g-ampo/mesh_module/ESP_mesh_module/Mesh_Gerbers/BOM.xlsx

Comment | Designator | Footprint | LCSC Part #
BAT54JFILM | D1 | SOT-323 | C86299 | -
BC817 | Q1, Q2 | SOD-23 | C52801 | -
10k | R1, R2, R3, R4 | 0805_R | C115295 | -
CP2102N-A01 | U2 | QFN-28 | C6568 | -
2k2 | R9, R11 | 0805_R | C26017 | -
22k | R7 | 0805_R | C139902 | -
47k | R8, R10 | 0805_R | C139872 | -
0R | R6, R5, R14, R15, R16, R17, R18, R22, R23, R24, R25, R26 | 0805_R | C702869 | -
PESD5V0L 1BA | D8, D9, D10 | SOD-323 | C85380 | -
100nF | C2, C3, C4, C5, C7, C11 | 0805_C | C360619 | -
4.7uF, 25V | C6 | 0805_C | C1779 | -
22uF, 25V | C1 | 0805_C | C5674 | -
ESP32-WROOM-32 | U1 | WiFi Module | C6568 | -
220 | R19, R20, R21 | 0805_R | C165202 | -
BZX84C47LT3 | D3, D4 | SOT-23 | C118591 | -
IRF7343PBF | Q3 | SOIC-8 | C558150
NCP1117-3.3 | U3 | SOT-223 | C146799 | -
10uF, 16V | C8, C9, C10 | 0805_C | C17024 | -
KPTD-3216SRC-PRV | D2, D5, D6, D7 | 1206_LED | C598387 | -
