g-ampo/mesh_module/ESP_mesh_module/Mesh Module Schematics.pdf

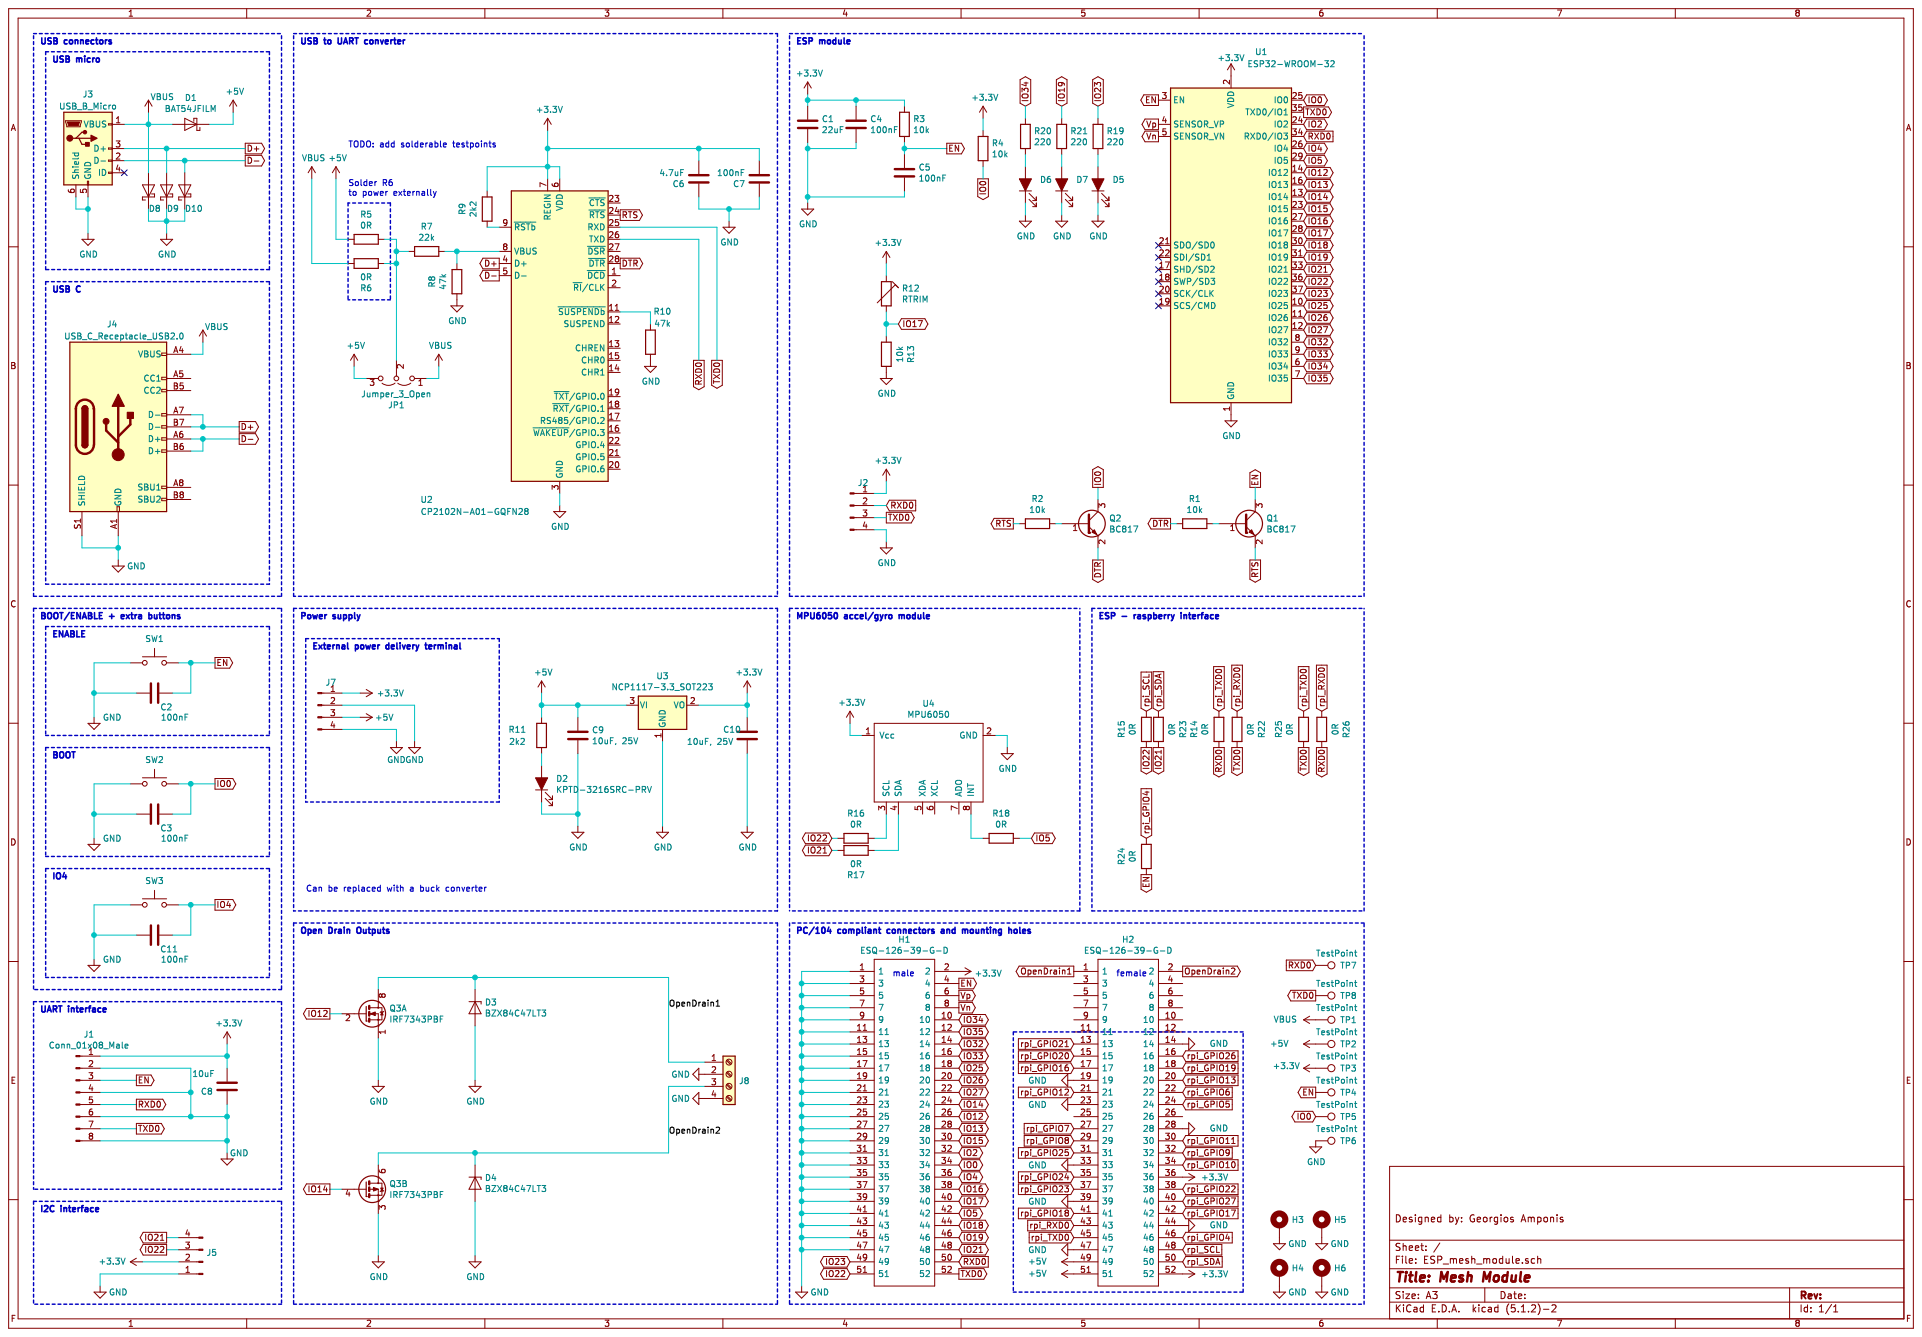
[picture p1: page 1]
