g-ampo/mesh_module/ESP_mesh_module/ESP_mesh_module.kicad_pcb

## KiCad design ESP_mesh_module/ESP_mesh_module.kicad_pcb (2020-11-23)

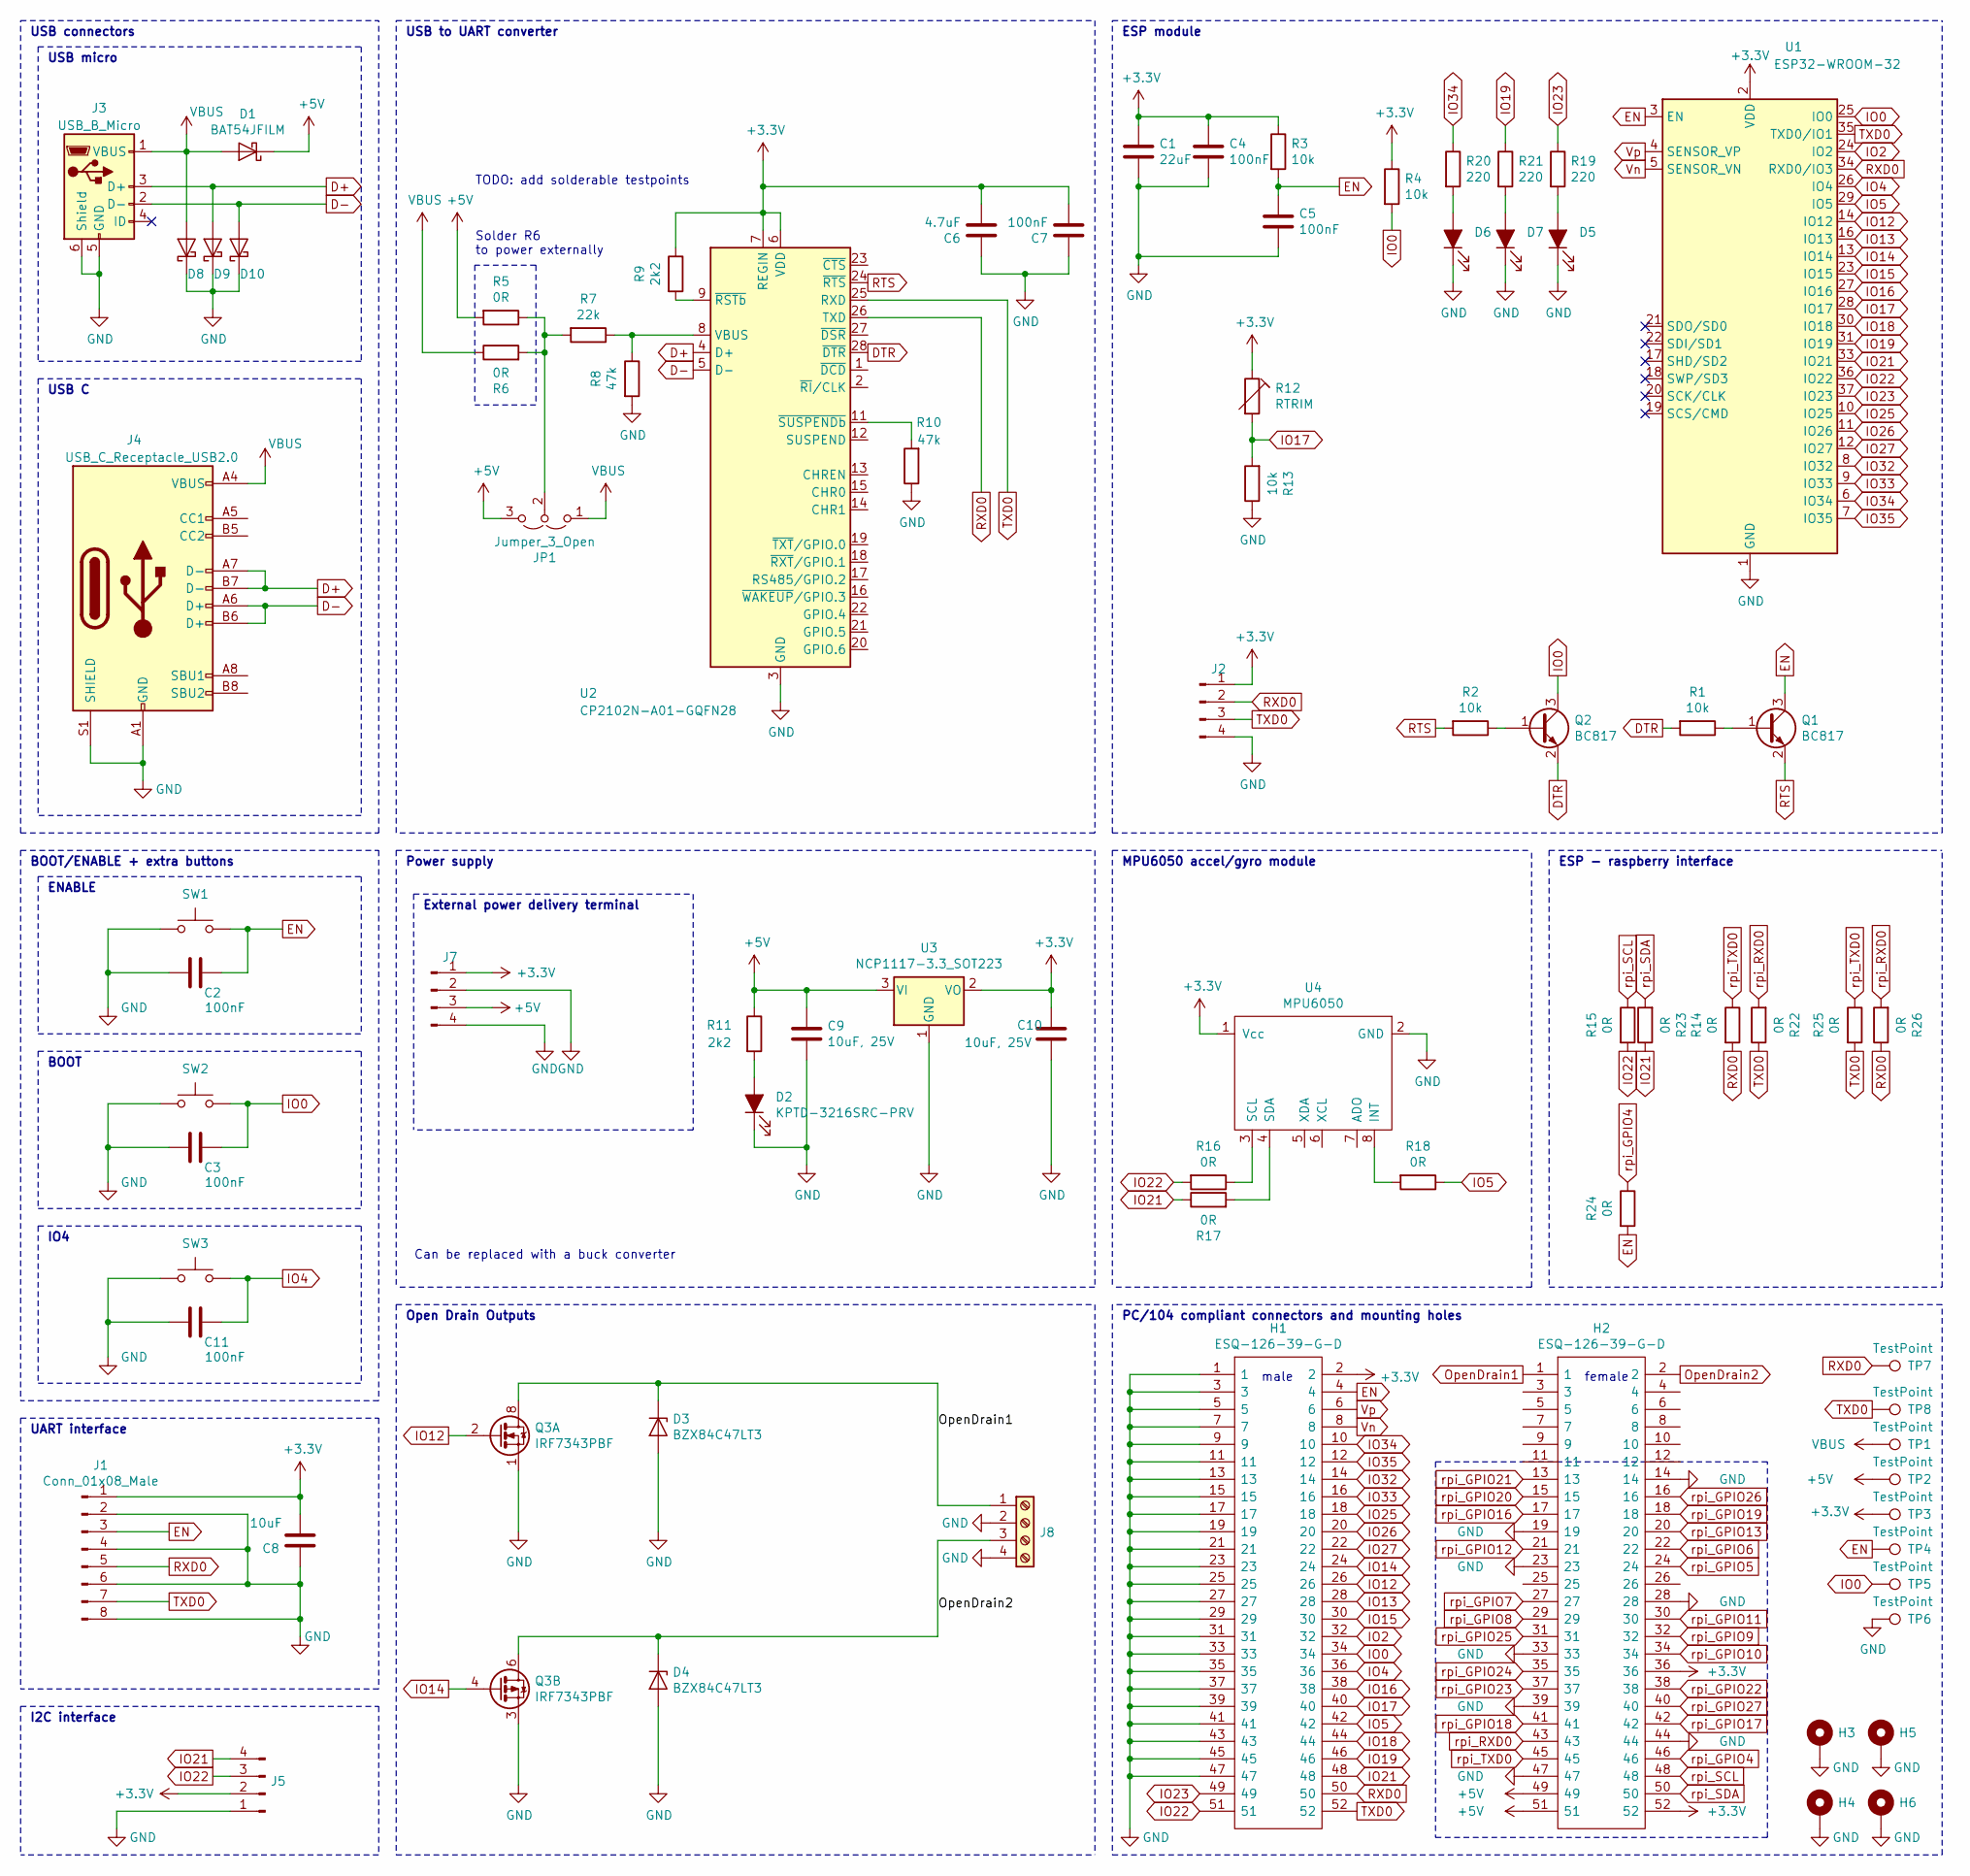
[picture p2: schematic ESP_mesh_module.sch, Mesh Module]

Parts:
C1: 22uF; R_0805_2012Metric; LCSC C5674
C2, C3, C4, C5, C7, C11: 100nF; R_0805_2012Metric; LCSC C360619
C6: 4.7uF; R_0805_2012Metric; LCSC C1779
C8: 10uF; R_0805_2012Metric; LCSC C17024
C9, C10: 10uF, 25V; R_0805_2012Metric; LCSC C17024
D1: BAT54JFILM; D_SOD-323_HandSoldering
D2, D5, D6, D7: KPTD-3216SRC-PRV; LED_1206_3216Metric; LCSC C598387
D3, D4: BZX84C47LT3; D_SOT-23_ANK; LCSC C118591
D8, D9, D10: PESD5V0L 1BA; D_SOD-323_HandSoldering; LCSC C85380
H1, H2: ESQ-126-39-G-D; SHDR52W64P254_2X26_6550X495X1384P; Manufacturer_Part_Number ESQ-126-39-G-D; Mouser Part Number 200-ESQ12639GD
H3, H4, H5, H6: MountingHole_Pad; Mounting_hole_PC104
J1: Conn_01x08_Male; IDC-Header_2x04_P2.54mm_Vertical
J2, J5, J7: Conn_01x04_Male; PinHeader_1x04_P2.54mm_Vertical
J3: USB_B_Micro; USB_Micro-B_Molex_47346-0001
J4: USB_C_Receptacle_USB2.0
J8: Screw_Terminal_01x04; PinHeader_1x04_P2.54mm_Vertical
JP1: Jumper_3_Open; PinHeader_1x03_P2.54mm_Vertical
Q1, Q2: BC817; SOT-23; LCSC C52801
Q3: IRF7343PBF; SOIC-8_3.9x4.9mm_P1.27mm; LCSC C558150
R1, R2, R4: 10k; R_0805_2012Metric; LCSC C115295
R3: 10k; R_0805_2012Metric
R5, R6, R14, R15, R16, R17, R18, R22, R23, R24, R25, R26: 0R; R_0805_2012Metric; LCSC C702869
R7: 22k; R_0805_2012Metric; LCSC C139902
R8, R10: 47k; R_0805_2012Metric; LCSC C139872
R9, R11: 2k2; R_0805_2012Metric; LCSC C26017
R12: RTRIM; Potentiometer_Piher_PT-6-V_Vertical
R13: 10k; R_Axial_DIN0207_L6.3mm_D2.5mm_P7.62mm_Horizontal
R19, R20, R21: 220; R_0805_2012Metric; LCSC C165202
SW1, SW2, SW3: SW_Push; SW_PUSH_6mm
TP1, TP2, TP3, TP4, TP5, TP6, TP7, TP8: TestPoint; TestPoint_Pad_D1.5mm
U1: ESP32-WROOM-32; LCSC C82899
U2: CP2102N-A01-GQFN28; QFN-28-1EP_5x5mm_P0.5mm_EP3.35x3.35mm; LCSC C6568
U3: NCP1117-3.3_SOT223; SOT-223-3_TabPin2; LCSC C146799
U4: MPU6050

Connections:
+3V3: C1.1, C4.1, C6.2, C7.2, C8.2, C10.1, H1.2, H2.36, H2.52, J1.1, J2.1, J5.2, J7.1, R3.1, R4.1, R9.1, R12.1, TP3.1, U1.2 (VDD), U2.6 (VDD), U2.7 (REGIN), U3.2 (VO), U4.1 (Vcc)
+5V: C9.1, D1.1 (K), H2.49, H2.51, J7.3, JP1.3 (B), R5.2, R11.1, TP2.1, U3.3 (VI)
D+: D9.2 (A), J3.3 (D+), J4.A7 (D-), J4.B7 (D-), U2.4 (D+)
D-: D10.2 (A), J3.2 (D-), J4.A6 (D+), J4.B6 (D+), U2.5 (D-)
DTR: Q2.2 (E), R1.2, U2.28 (~DTR)
EN: C2.1, C5.1, H1.4, J1.3, Q1.3 (C), R3.2, R24.2, SW1.2, TP4.1, U1.3 (EN)
GND: C1.2, C2.2, C3.2, C4.2, C5.2, C6.1, C7.1, C8.1, C9.2, C10.2, C11.2, D2.1 (K), D3.2 (A), D4.2 (A), D5.1 (K), D6.1 (K), D7.1 (K), D8.1 (K), D9.1 (K), D10.1 (K), H1.1, H1.3, H1.5, H1.7, H1.9, H1.11, H1.13, H1.15, H1.17, H1.19, H1.21, H1.23, H1.25, H1.27, H1.29, H1.31, H1.33, H1.35, H1.37, H1.39, H1.41, H1.43, H1.45, H1.47, H2.14, H2.19, H2.23, H2.28, H2.33, H2.39, H2.44, H2.47, H3.1, H4.1, H5.1, H6.1, J1.2, J1.4, J1.6, J1.8, J2.4, J3.5 (GND), J3.6 (Shield), J4.A1 (GND), J4.A12 (GND), J4.B1 (GND), J4.B12 (GND), J4.S1 (SHIELD), J5.1, J7.2, J7.4, J8.2, J8.4, Q3.1 (S), Q3.3 (1), R8.2, R10.1, R13.1, SW1.1, SW2.1, SW3.1, TP6.1, U1.1 (GND), U1.15 (GND), U1.38 (GND), U1.39, U2.3 (GND), U2.29 (GND), U3.1 (GND), U4.2 (GND)
IO0: C3.1, H1.34, Q2.3 (C), R4.2, SW2.2, TP5.1, U1.25 (IO0)
IO2: H1.32, U1.24 (IO2)
IO4: C11.1, H1.36, SW3.2, U1.26 (IO4)
IO5: H1.42, R18.1, U1.29 (IO5)
IO12: H1.26, Q3.2 (G), U1.14 (IO12)
IO13: H1.28, U1.16 (IO13)
IO14: H1.24, Q3.4 (G), U1.13 (IO14)
IO15: H1.30, U1.23 (IO15)
IO16: H1.38, U1.27 (IO16)
IO17: H1.40, R12.2, R13.2, U1.28 (IO17)
IO18: H1.44, U1.30 (IO18)
IO19: H1.46, R21.1, U1.31 (IO19)
IO21: H1.48, J5.4, R17.1, R23.1, U1.33 (IO21)
IO22: H1.51, J5.3, R15.2, R16.2, U1.36 (IO22)
IO23: H1.49, R19.1, U1.37 (IO23)
IO25: H1.18, U1.10 (IO25)
IO26: H1.20, U1.11 (IO26)
IO27: H1.22, U1.12 (IO27)
IO32: H1.14, U1.8 (IO32)
IO33: H1.16, U1.9 (IO33)
IO34: H1.10, R20.1, U1.6 (IO34)
IO35: H1.12, U1.7 (IO35)
unnamed: D2.2 (A), R11.2
unnamed: D5.2 (A), R19.2
unnamed: D6.2 (A), R20.2
unnamed: D7.2 (A), R21.2
unnamed: JP1.2 (C), R5.1, R6.2, R7.2
unnamed: Q1.1 (B), R1.1
unnamed: Q2.1 (B), R2.1
unnamed: R7.1, R8.1, U2.8 (VBUS)
unnamed: R9.2, U2.9 (~RSTb)
unnamed: R10.2, U2.11 (~SUSPENDb)
unnamed: R16.1, U4.3 (SCL)
unnamed: R17.2, U4.4 (SDA)
unnamed: R18.2, U4.8 (INT)
OpenDrain1: D3.1 (K), H2.1, J8.1, Q3.7 (D), Q3.8 (D)
OpenDrain2: D4.1 (K), H2.2, J8.3, Q3.5 (D), Q3.6 (D)
RTS: Q1.2 (E), R2.2, U2.24 (~RTS)
RXD0: H1.50, J1.5, J2.2, R14.2, R26.1, TP7.1, U1.34 (RXD0/IO3), U2.26 (TXD)
TXD0: H1.52, J1.7, J2.3, R22.1, R25.2, TP8.1, U1.35 (TXD0/IO1), U2.25 (RXD)
VBUS: D1.2 (A), D8.2 (A), J3.1 (VBUS), J4.A4 (VBUS), J4.A9 (VBUS), J4.B4 (VBUS), J4.B9 (VBUS), JP1.1 (A), R6.1, TP1.1
Vn: H1.8, U1.5 (SENSOR_VN)
Vp: H1.6, U1.4 (SENSOR_VP)
rpi_GPIO4: H2.46, R24.1
rpi_GPIO5: H2.24
rpi_GPIO6: H2.22
rpi_GPIO7: H2.27
rpi_GPIO8: H2.29
rpi_GPIO9: H2.32
rpi_GPIO10: H2.34
rpi_GPIO11: H2.30
rpi_GPIO12: H2.21
rpi_GPIO13: H2.20
rpi_GPIO16: H2.17
rpi_GPIO17: H2.42
rpi_GPIO18: H2.41
rpi_GPIO19: H2.18
rpi_GPIO20: H2.15
rpi_GPIO21: H2.13
rpi_GPIO22: H2.38
rpi_GPIO23: H2.37
rpi_GPIO24: H2.35
rpi_GPIO25: H2.31
rpi_GPIO26: H2.16
rpi_GPIO27: H2.40
rpi_RXD0: H2.43, R22.2, R26.2
rpi_SCL: H2.48, R15.1
rpi_SDA: H2.50, R23.2
rpi_TXD0: H2.45, R14.1, R25.1

Notes on the sheet:
USB connectors
ESP module
TODO: add solderable testpoints
Solder R6 to power externally
USB to UART converter
USB micro
USB C
MPU6050 accel/gyro module
PC/104 compliant connectors and mounting holes
Open Drain Outputs
BOOT
ENABLE
Can be replaced with a buck converter
External power delivery terminal
Power supply
UART interface
BOOT/ENABLE + extra buttons
IO4
I2C interface
female
male
ESP - raspberry interface

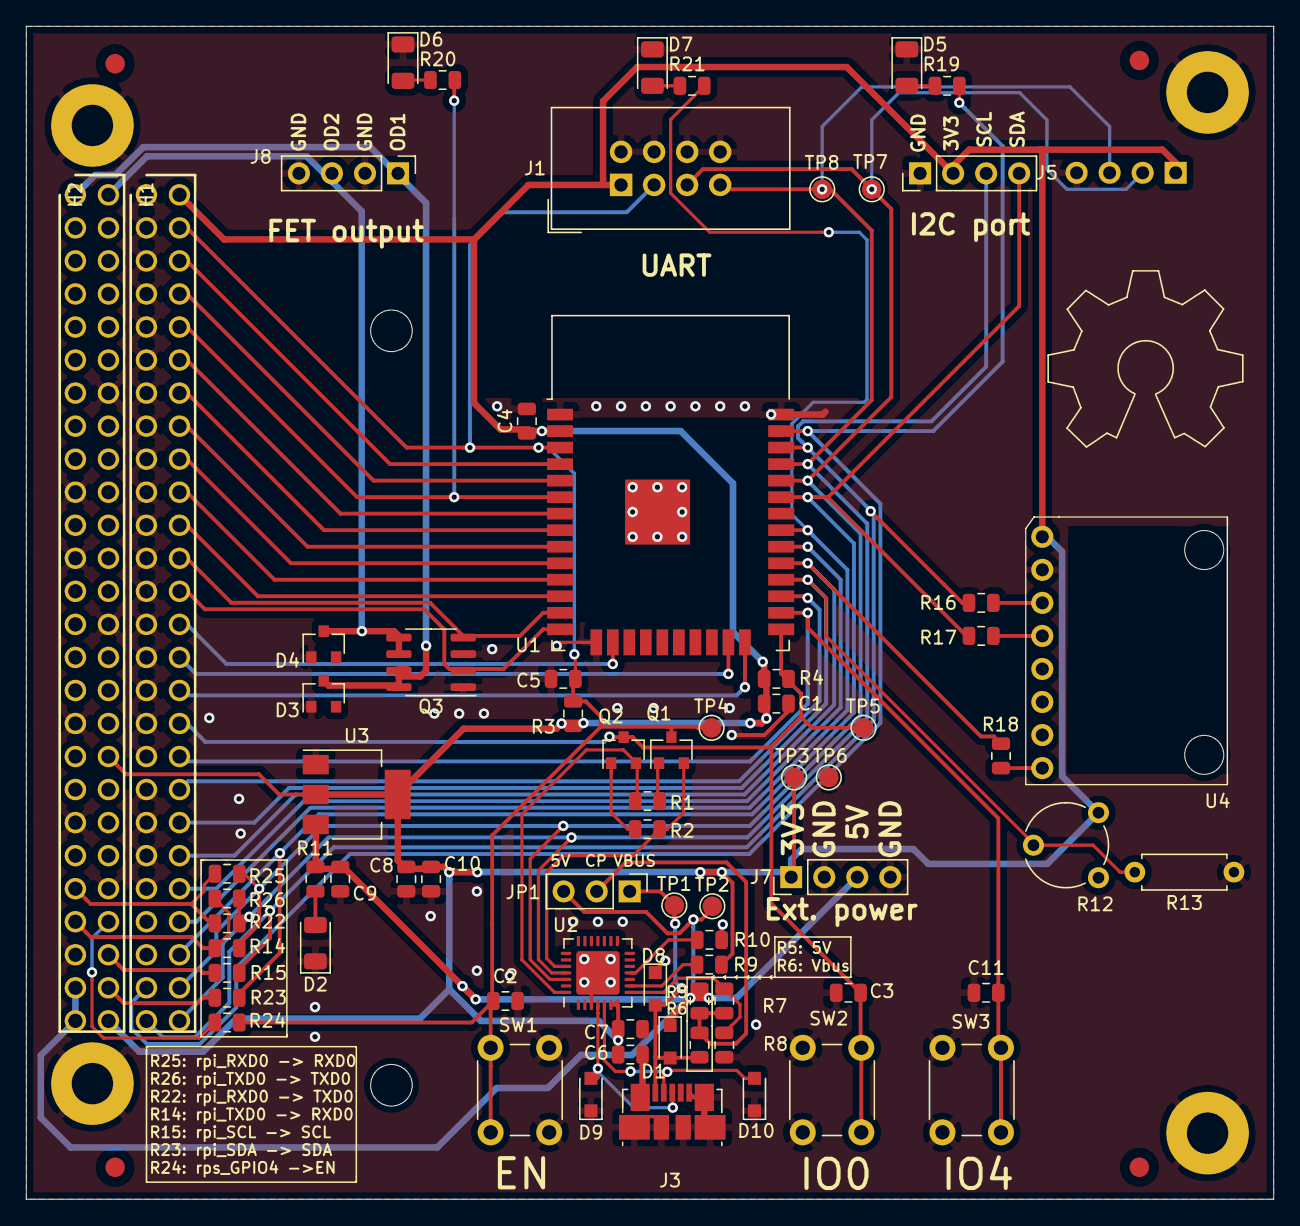
[picture p3: board ESP_mesh_module.kicad_pcb from above]

Board: 2 copper layers, 95.9 x 90.2 mm, 80 parts (1 on the bottom side), 55 nets.

Other parts of the board:
rpi_mount: MountingHole_3.2mm_M3
rpi_mount#2: MountingHole_3.2mm_M3
